H-Bombmxpwr/FPV_Drone/README.md

# FPV Drone Project - ECE 445

This repository contains the design and implementation files for the FPV (First-Person View) Drone project developed by Hunter, Eli, and Griffin for the ECE 445 final project at the University of Illinois in the Spring of 2024.

## Project Overview

The FPV Drone project aims to create a robust and user-friendly drone capable of transmitting real-time video to the user, providing an immersive flying experience. This project was proposed by John M. Hart from the center of Autonomy at the University of Illinois. This repository includes everything that was used in one way or another to make this project. 

## Directories

- Code
   - Low level arduino and c code for flashing the microcontrollers 
- crazyflie_control
   - Software to control the Crazyflie Drone
   - Firmware to flash the Crazyflie Done
   - Extensive debugging tools for setup
- Documents
   - Power Points
   - Design Documents
   - PCB schematics and gerbers
   - Images
   - Personal notes
   - Needed Documentation

## Getting Started
If you are looking to control the drone with your computer you will need:
- Crazyflie 2.0 Drone
- Crazyradio or Crazyflie PA
- Gaming Controller Controller

Then follow the list of steps in [install.md](install.md). 

## The Project

It can be found at this [link](https://courses.engr.illinois.edu/ece445/projects.asp) under "Spring 2024". We were team 64. To save time some material is also linked below:

- [Design Document](Documents/documentation/Design_Document_ECE_445.pdf)
- [Video](https://youtu.be/XnW3fZcY0gs)
- [Final Paper](Documents/documentation/ECE_445_Final_Paper_ECE445.pdf)

## Acknowledgments

- Jon Hart
- Dennis McCann
- Tianxiang Zheng
- Bitlooney

Project Link: [https://github.com/H-Bombmxpwr/FPV_Drone](https://github.com/H-Bombmxpwr/FPV_Drone)
