H-Bombmxpwr/FPV_Drone/Documents/images/ece445blockdiagram.pptx

On Drone System

Camera

Wifi Connection

CrazyFlie Drone

Accelerometer

Barometer

Battery

ESP32 MCU

Sensor Data Overlay

Array Programmer

Wifi Chip

3.3V

3V

CVBS

On Headset System

ESP32 MCU

Wifi Chip

MiniHDMI Conversion

Power Subsystem

Voltage Regulators

3.7V

Battery

MiniHDMI

Headset

IF LED Array

3.3V

Power Subsystem

Voltage Regulators

3.7V
