H-Bombmxpwr/FPV_Drone/Documents/images/64_drone.png

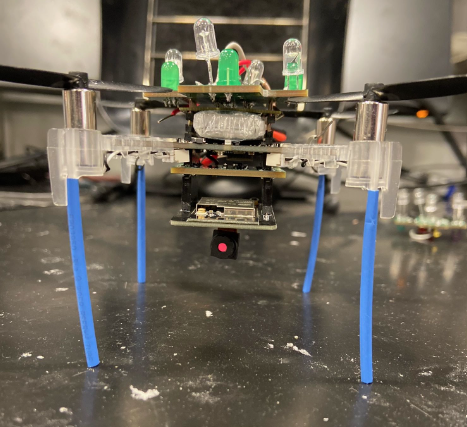
Documents/images/64_drone.png
