H-Bombmxpwr/FPV_Drone/Documents/images/64_headset_board.png

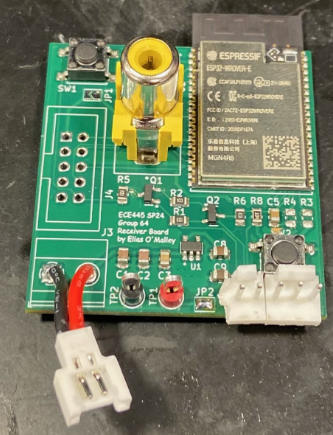
Documents/images/64_headset_board.png
