H-Bombmxpwr/FPV_Drone/Documents/images/av.png

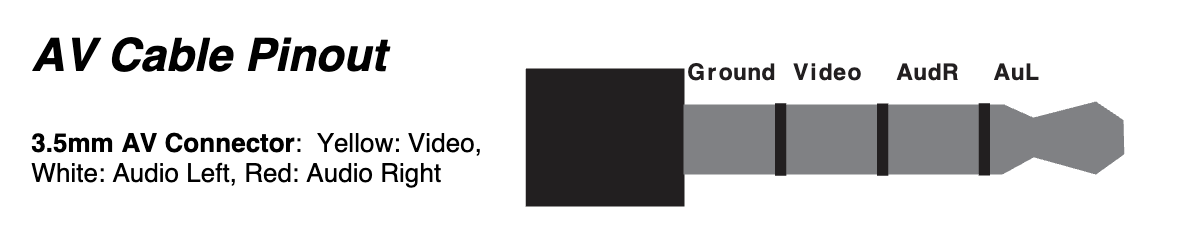
Documents/images/av.png
