H-Bombmxpwr/FPV_Drone/Documents/images/Final Block Diagram.png

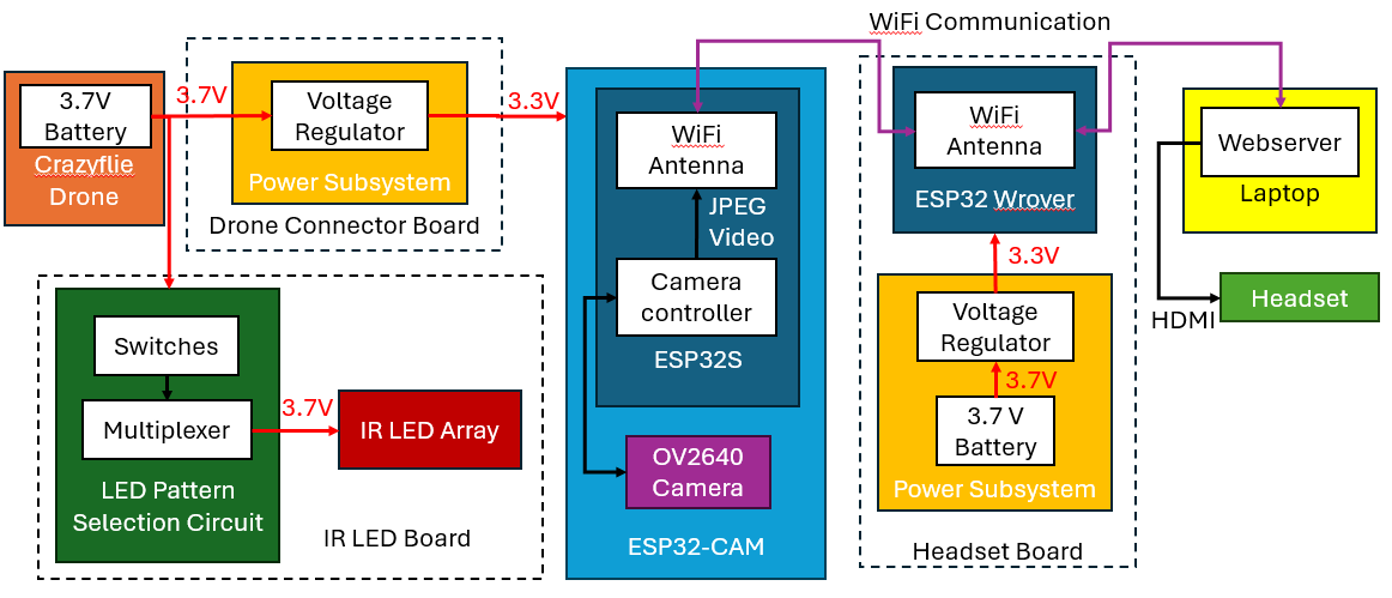
Documents/images/Final Block Diagram.png
