H-Bombmxpwr/FPV_Drone/Documents/images/LEDconfig.png

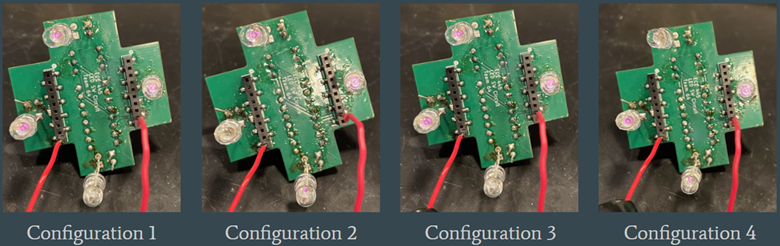
Documents/images/LEDconfig.png
