H-Bombmxpwr/FPV_Drone/Documents/images/locker.png

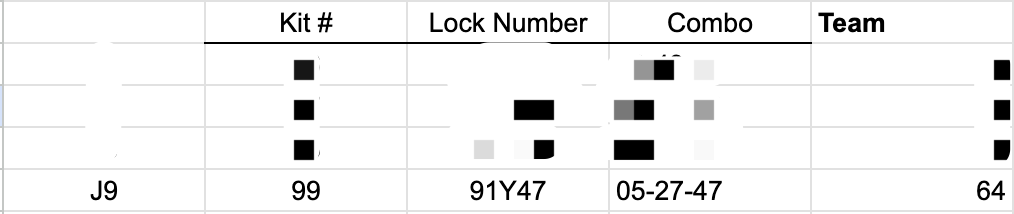
Documents/images/locker.png
