H-Bombmxpwr/FPV_Drone/Documents/kicad/adapter_board/adapter_board/visuals/adapter_board_bottom.png

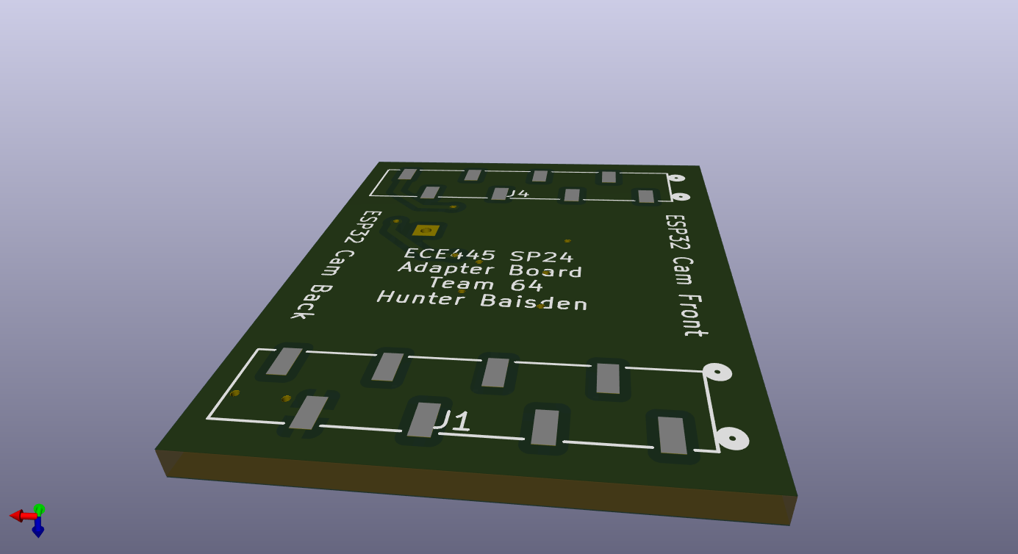
Documents/kicad/adapter_board/adapter_board/visuals/adapter_board_bottom.png
