H-Bombmxpwr/FPV_Drone/Documents/kicad/adapter_board/adapter_board/visuals/adapter_board_pcb.png

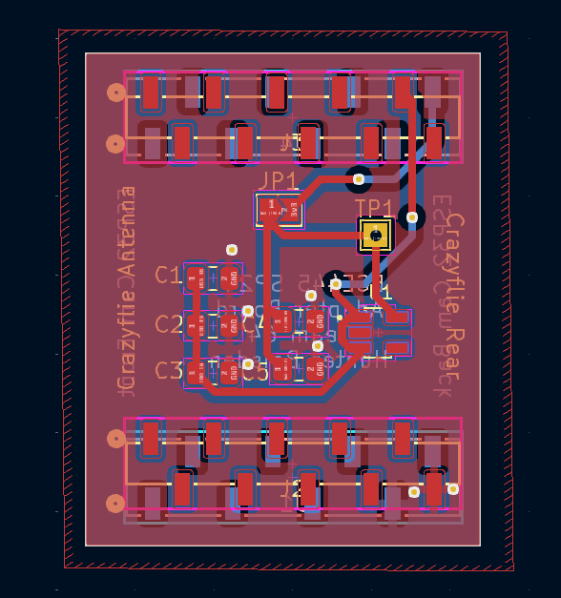
Documents/kicad/adapter_board/adapter_board/visuals/adapter_board_pcb.png
