H-Bombmxpwr/FPV_Drone/Documents/kicad/adapter_board/adapter_board/AP2112K_3_3TRG1/AP2112K-3.3TRG1.step

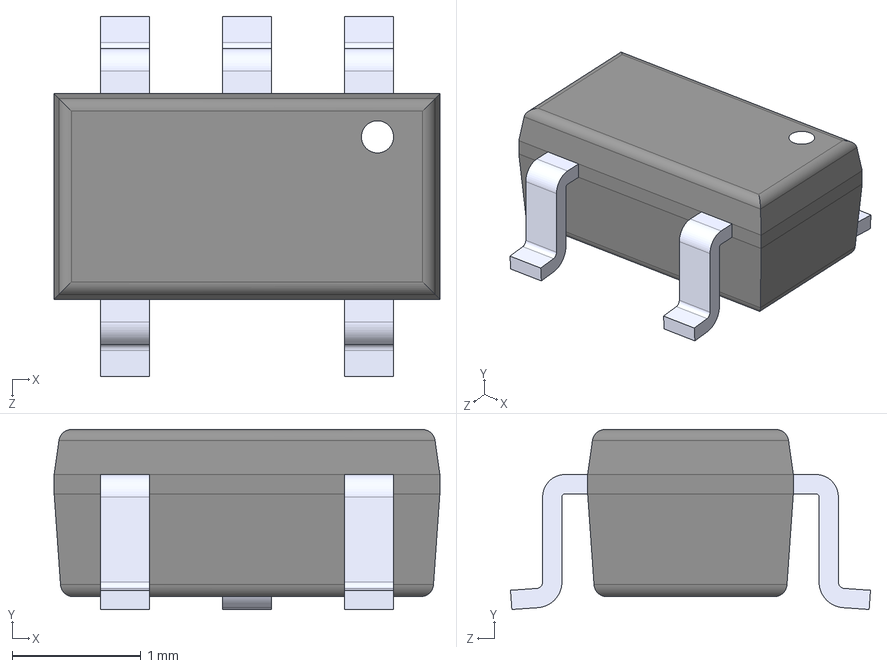
[picture p19: CAD file, 2024-03-31]
Documents/kicad/adapter_board/adapter_board/AP2112K_3_3TRG1/AP2112K-3.3TRG1.step
3.00 x 1.40 x 2.80 mm
