H-Bombmxpwr/FPV_Drone/Documents/kicad/LED_BOARD/L08R5000Q1/L08R5000Q1.step

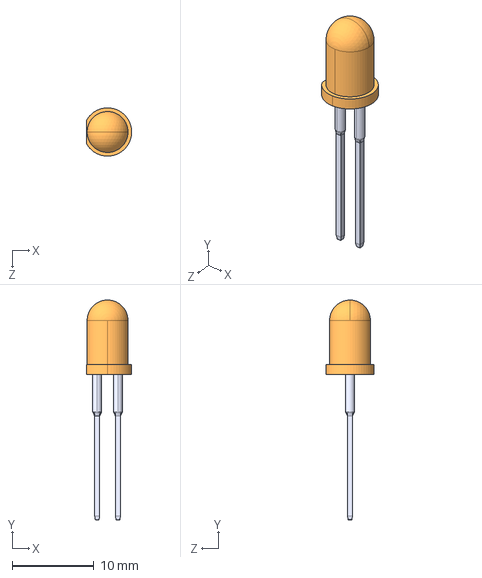
[picture p20: CAD file, 2024-03-31]
Documents/kicad/LED_BOARD/L08R5000Q1/L08R5000Q1.step
5.55 x 26.9 x 5.90 mm
