H-Bombmxpwr/FPV_Drone/Documents/kicad/adapter_board/adapter_board/visuals/adapter_board-B_Silkscreen.pdf

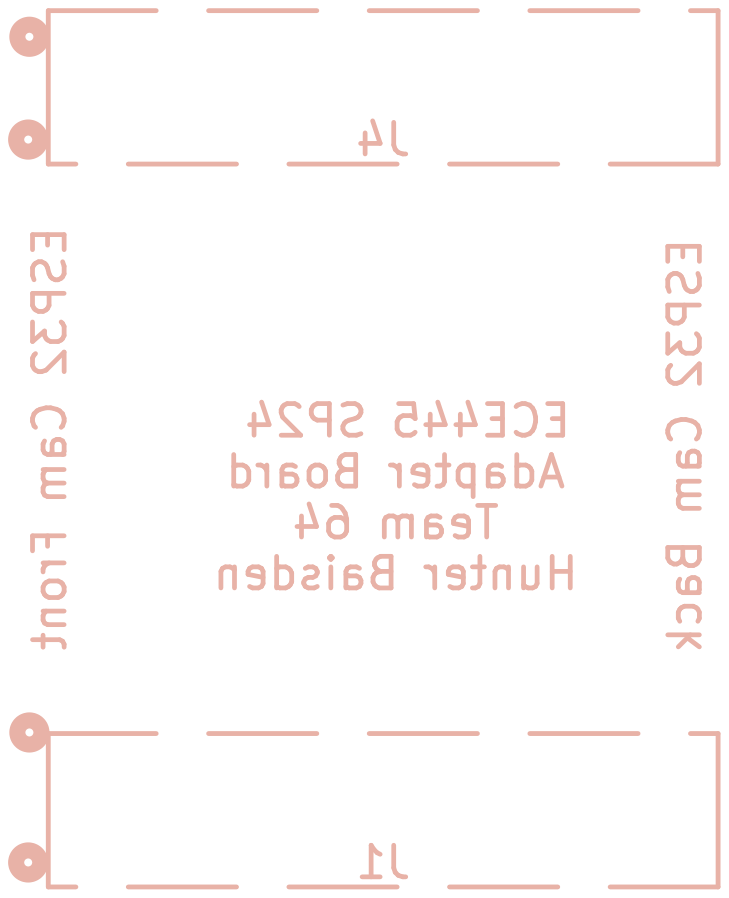
[picture p28: page 1]

Baisden Hunter ESP32 Cam Front ESP32 Cam Back
