H-Bombmxpwr/FPV_Drone/Documents/kicad/adapter_board/adapter_board/visuals/adapter_board-F_Silkscreen.pdf

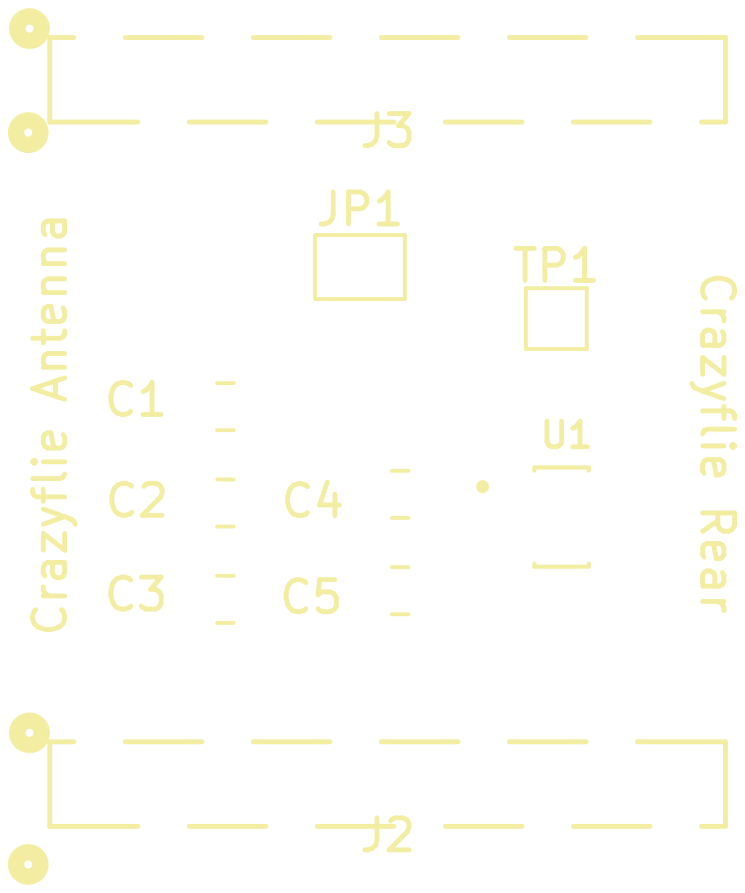
[picture p29: page 1]

Crazyflie Rear Crazyflie Antenna
