H-Bombmxpwr/FPV_Drone/Documents/kicad/adapter_board/adapter_board/visuals/adapter_board.pdf

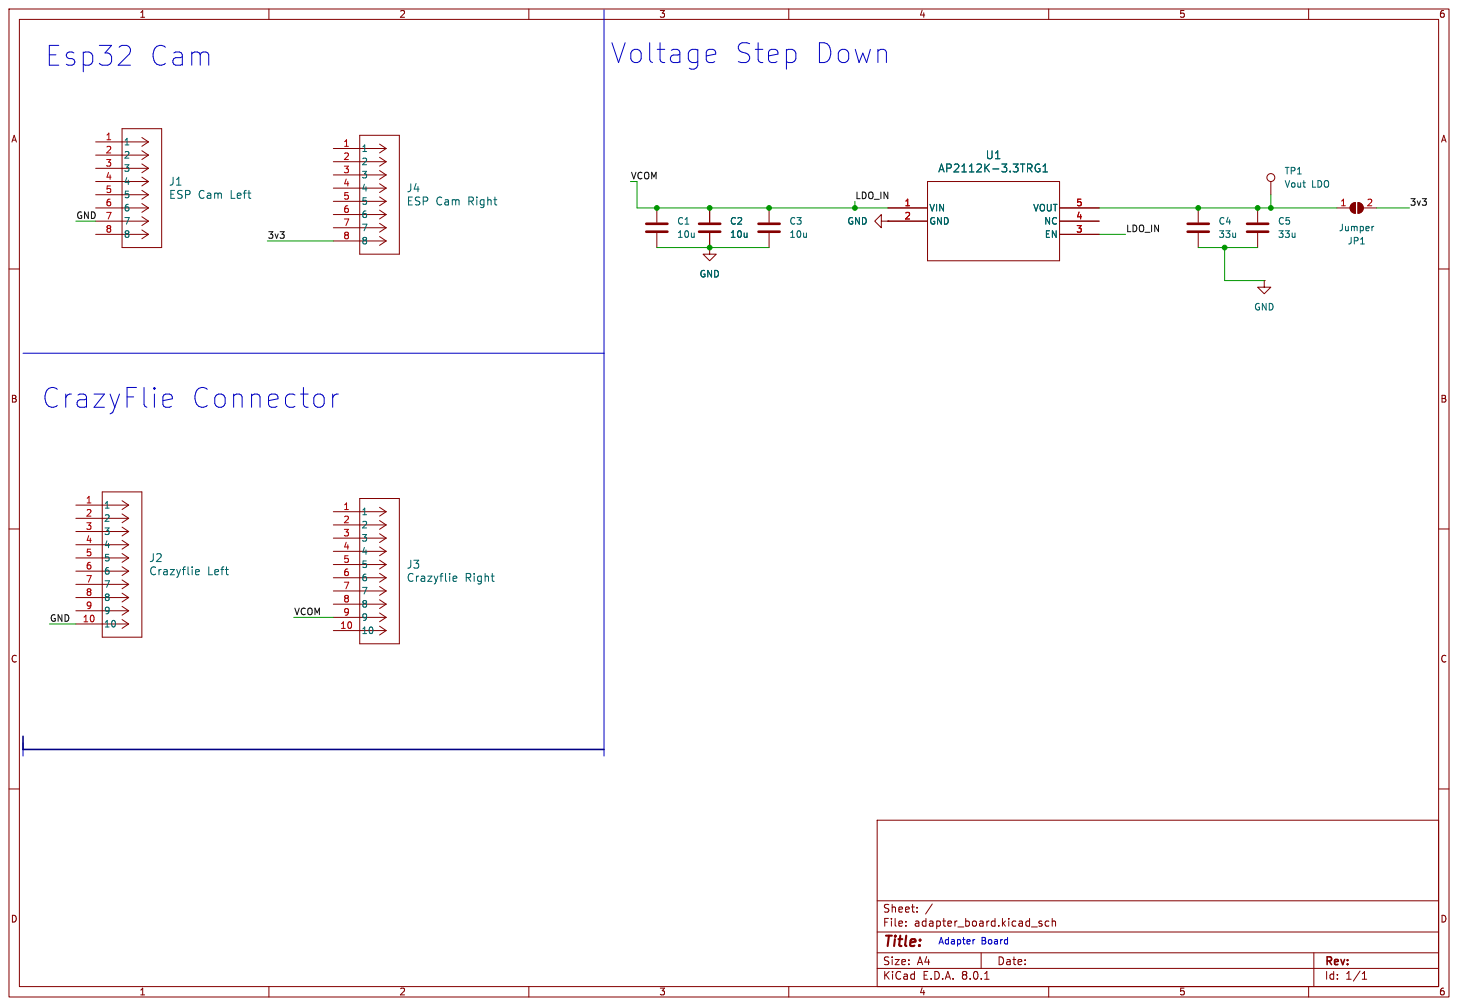
[picture p30: page 1]

Id: 1/1 Title: File: adapter_board.kicad_sch Sheet: /
