H-Bombmxpwr/FPV_Drone/Documents/kicad/adapter_board/adapter_board/visuals/adapter_board-B_Cu.pdf

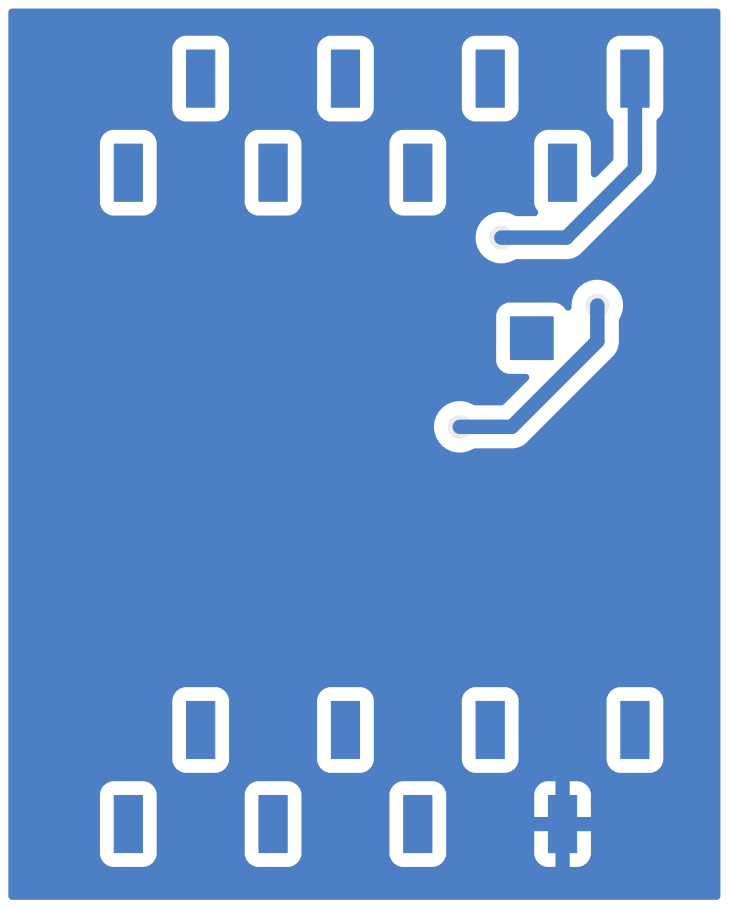
[picture p31: page 1]
