H-Bombmxpwr/FPV_Drone/Documents/kicad/adapter_board/adapter_board/visuals/adapter_board-B_Mask.pdf

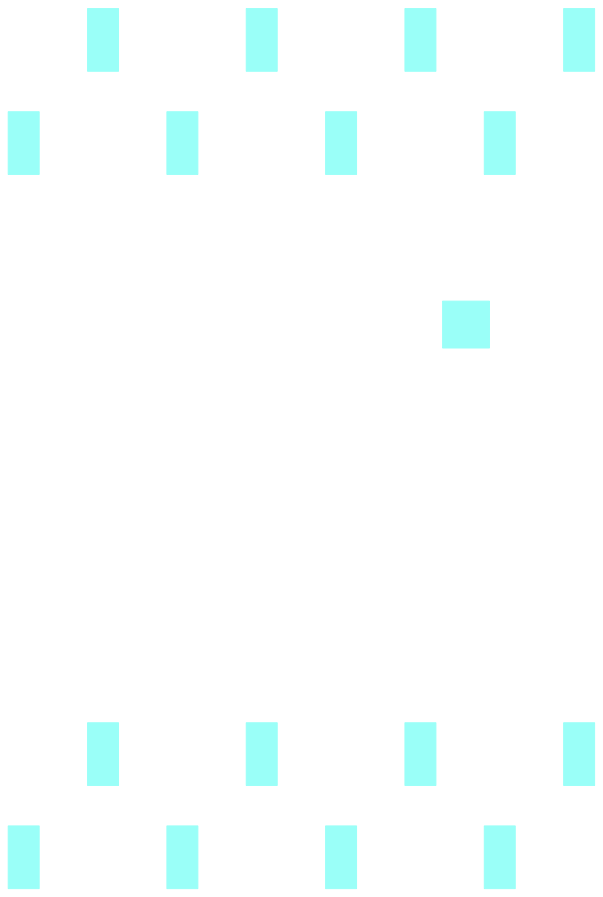
[picture p32: page 1]
