H-Bombmxpwr/FPV_Drone/Documents/kicad/adapter_board/adapter_board/visuals/adapter_board-B_Paste.pdf

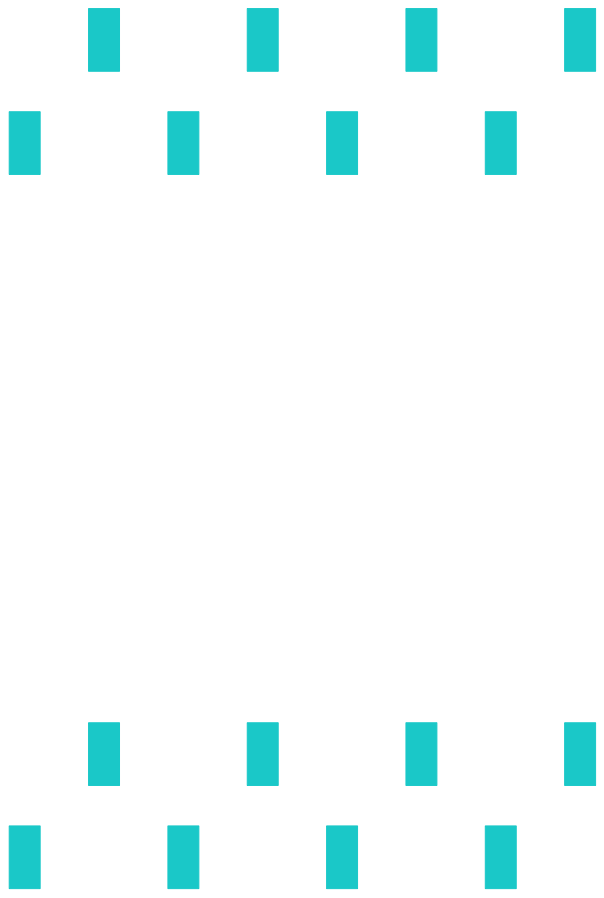
[picture p33: page 1]
