H-Bombmxpwr/FPV_Drone/Documents/kicad/adapter_board/adapter_board/visuals/adapter_board-F_Cu.pdf

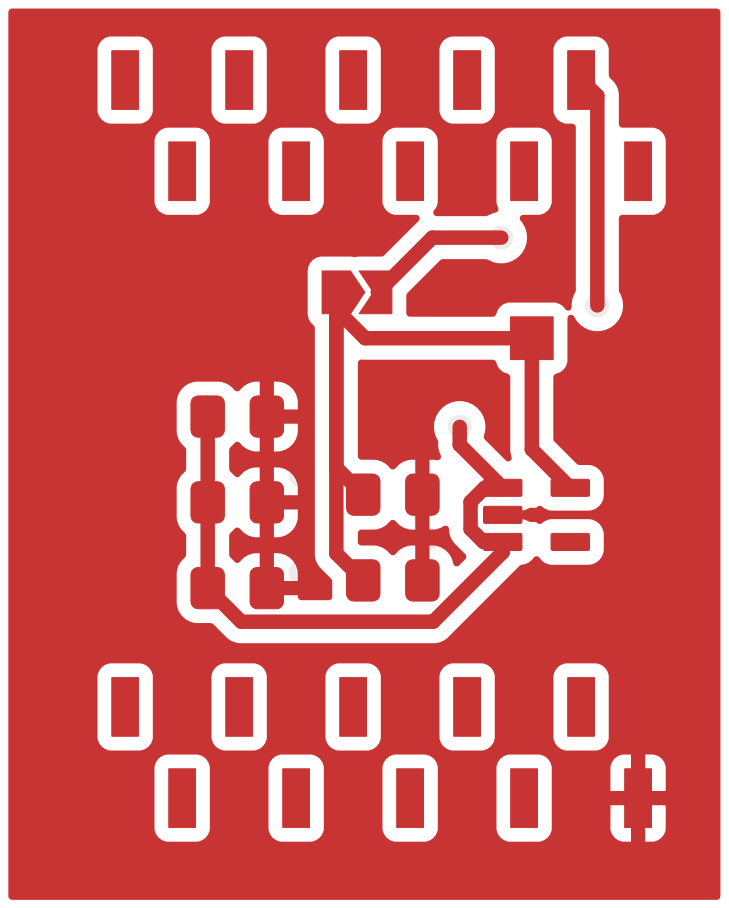
[picture p34: page 1]
