H-Bombmxpwr/FPV_Drone/Documents/kicad/adapter_board/adapter_board/visuals/adapter_board-F_Mask.pdf

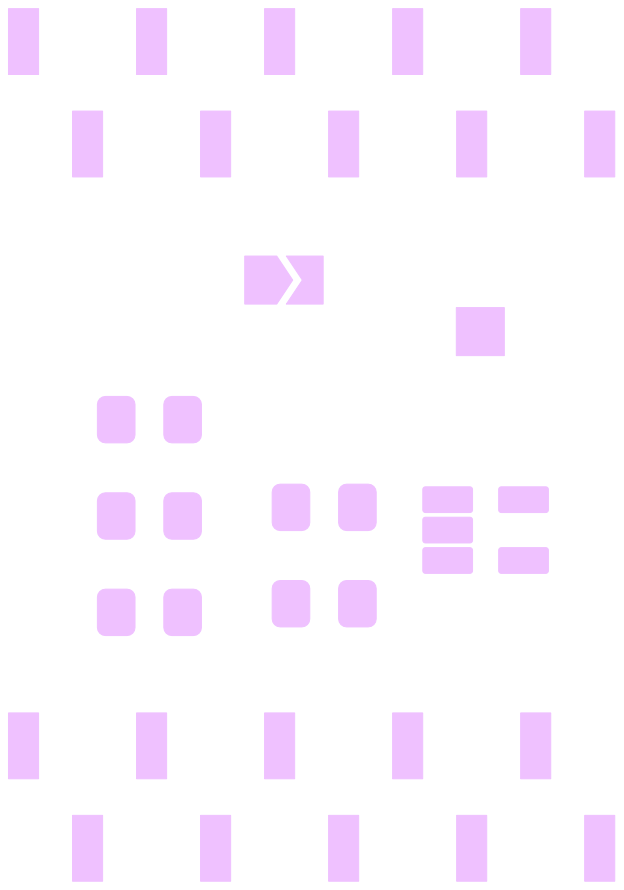
[picture p35: page 1]
