H-Bombmxpwr/FPV_Drone/Documents/kicad/adapter_board/adapter_board/visuals/adapter_board-F_Paste.pdf

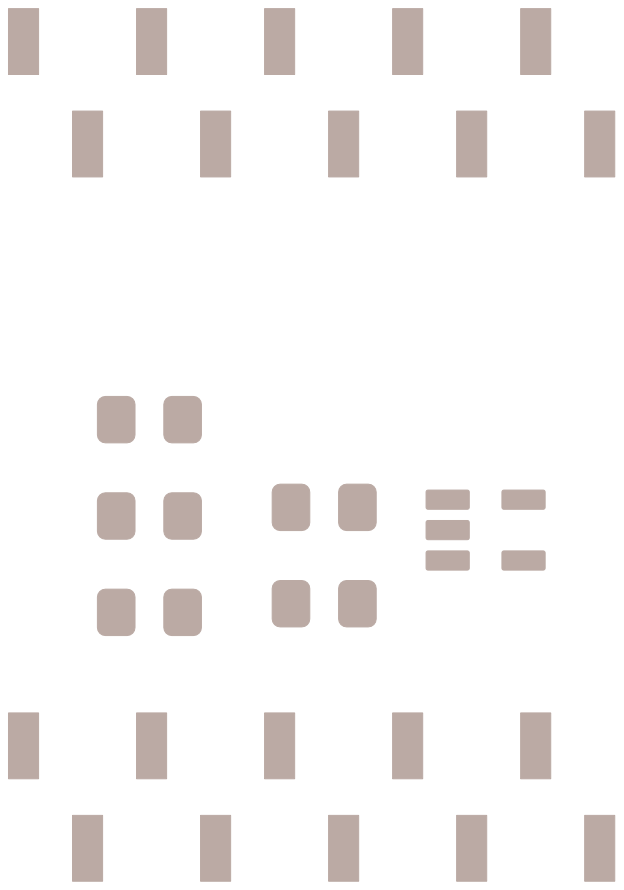
[picture p36: page 1]
