H-Bombmxpwr/FPV_Drone/Documents/kicad/LED_BOARD/Led circuit.kicad_pcb

## KiCad design Documents/kicad/LED_BOARD/Led circuit.kicad_pcb (2024-05-03)

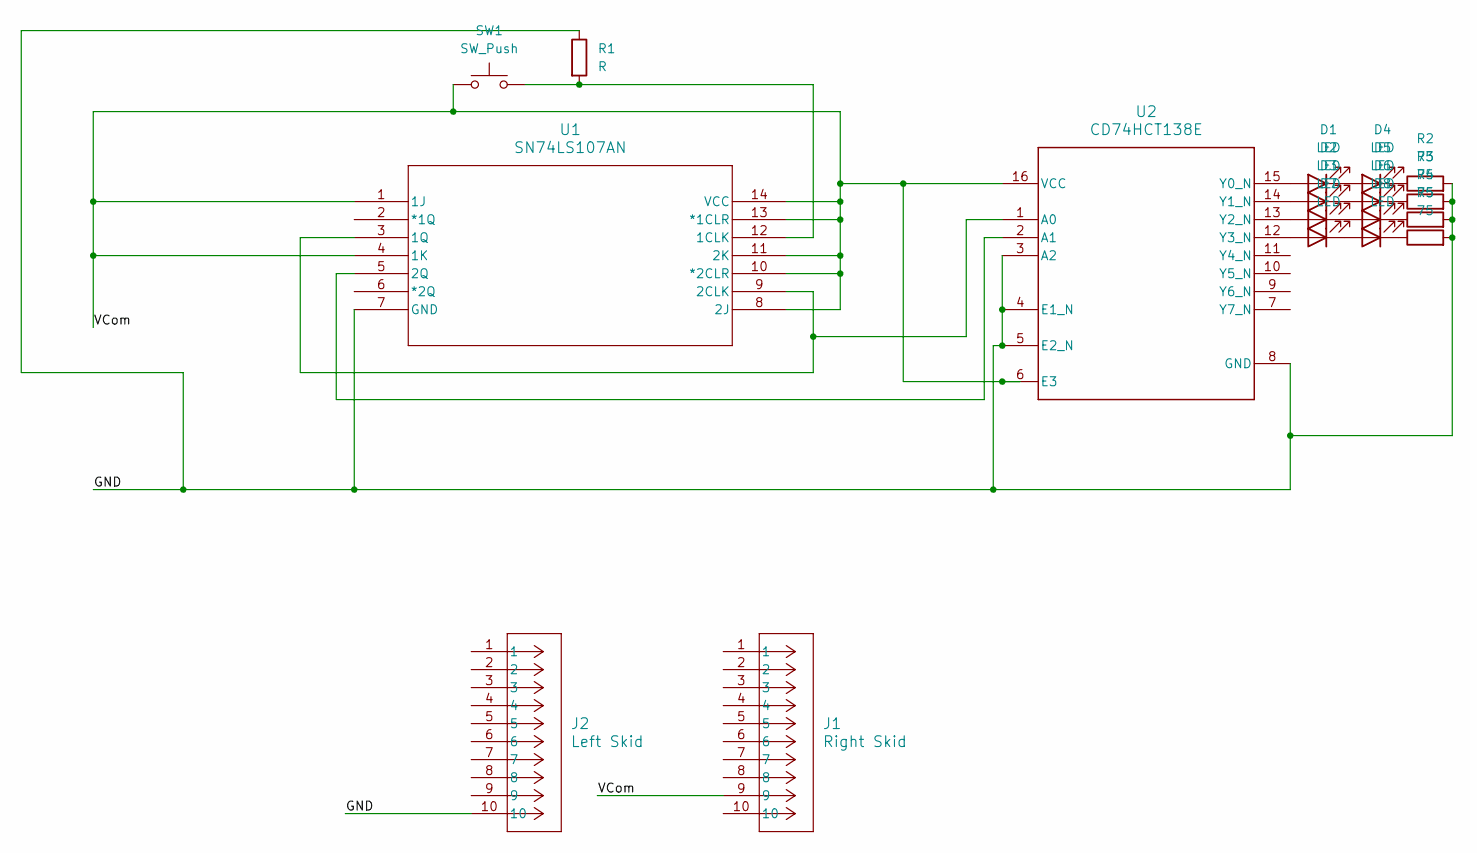
[picture p37: schematic Led circuit.kicad_sch]

Parts:
D1, D2, D3, D4, D5, D6, D7, D8: LED; LED_D2.0mm_W4.8mm_H2.5mm_FlatTop
J1: Right Skid; Connector
J2: Left Skid; Connector
R1: R
R2, R3, R4, R5: 75; R_0805_2012Metric_Pad1.20x1.40mm_HandSolder
SW1: SW_Push
U1: SN74LS107AN
U2: CD74HCT138E

Connections:
/GND: J2.10, R1.1, R2.2, R3.2, R4.2, R5.2, U1.7 (GND), U2.3 (A2), U2.4 (E1_N), U2.5 (E2_N), U2.8 (GND); also elsewhere on the board
/VCom: J1.9, SW1.1, U1.1 (1J), U1.4 (1K), U1.8 (2J), U1.10 (*2CLR), U1.11 (2K), U1.13 (*1CLR), U1.14 (VCC), U2.6 (E3), U2.16 (VCC)
unnamed: D1.2 (A), U2.15 (Y0_N)
unnamed: D1.1 (K), D4.2 (A)
unnamed: D2.2 (A), U2.14 (Y1_N)
unnamed: D2.1 (K), D5.2 (A)
unnamed: D3.2 (A), U2.13 (Y2_N)
unnamed: D3.1 (K), D6.2 (A)
unnamed: D4.1 (K), R2.1
unnamed: D5.1 (K), R3.1
unnamed: D6.1 (K), R4.1
unnamed: D7.2 (A), U2.12 (Y3_N)
unnamed: D7.1 (K), D8.2 (A)
unnamed: D8.1 (K), R5.1
unnamed 14: R1.2, SW1.2, U1.12 (1CLK); also elsewhere on the board
unnamed: U1.3 (1Q), U1.9 (2CLK), U2.1 (A0)
unnamed: U1.5 (2Q), U2.2 (A1)

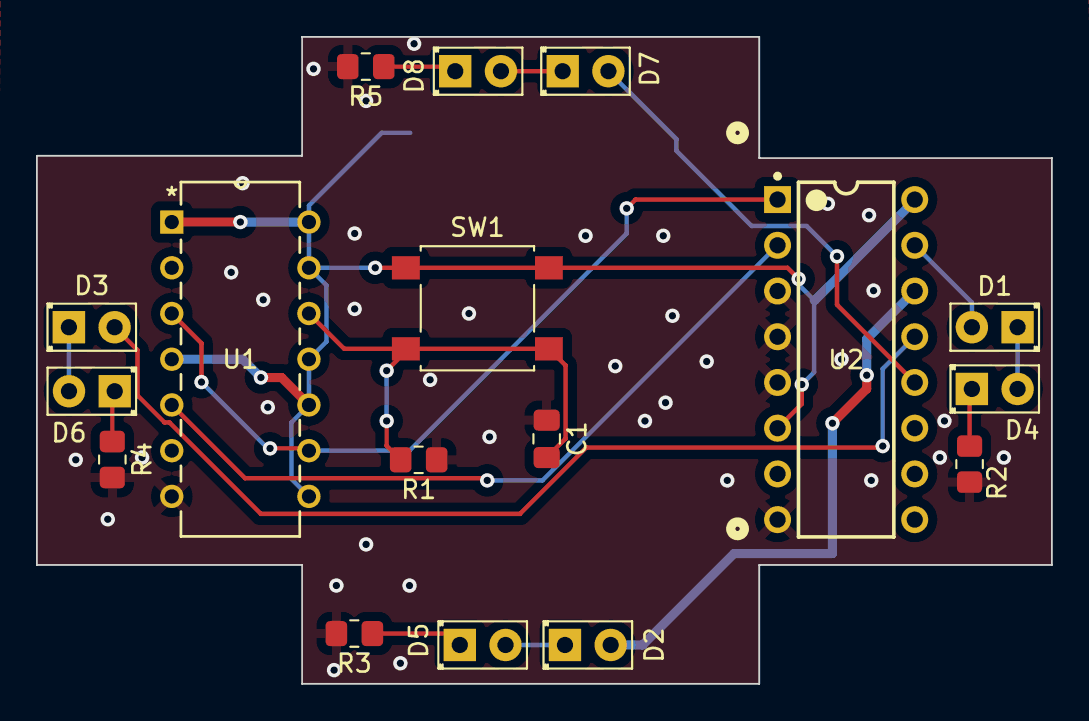
[picture p38: board Led circuit.kicad_pcb from above]

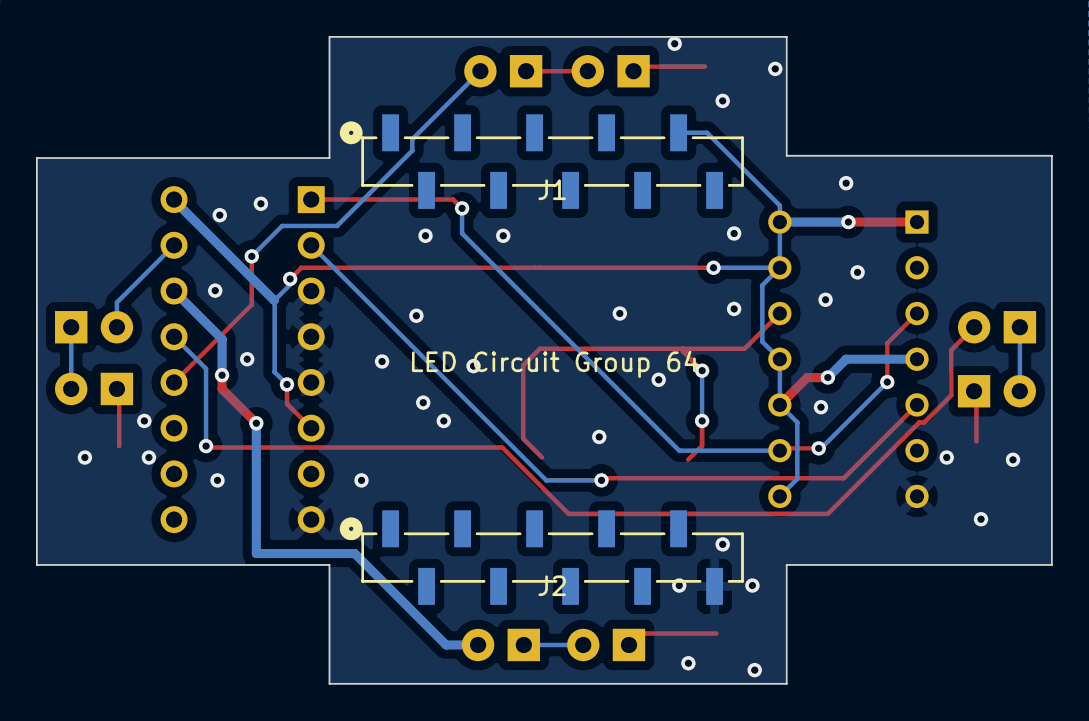
[picture p39: board Led circuit.kicad_pcb from below]

Board: 2 copper layers, 56.4 x 35.9 mm, 19 parts (2 on the bottom side), 17 nets.

Other parts of the board:
C1: C; C_0805_2012Metric_Pad1.18x1.45mm_HandSolder

Their connections:
/GND: C1.1; also elsewhere on the board
unnamed 14: C1.2; also elsewhere on the board
