H-Bombmxpwr/FPV_Drone/Documents/kicad/ece445_headset/ece445_headset.kicad_pcb

## KiCad design Documents/kicad/ece445_headset/ece445_headset.kicad_pcb (2024-04-08)

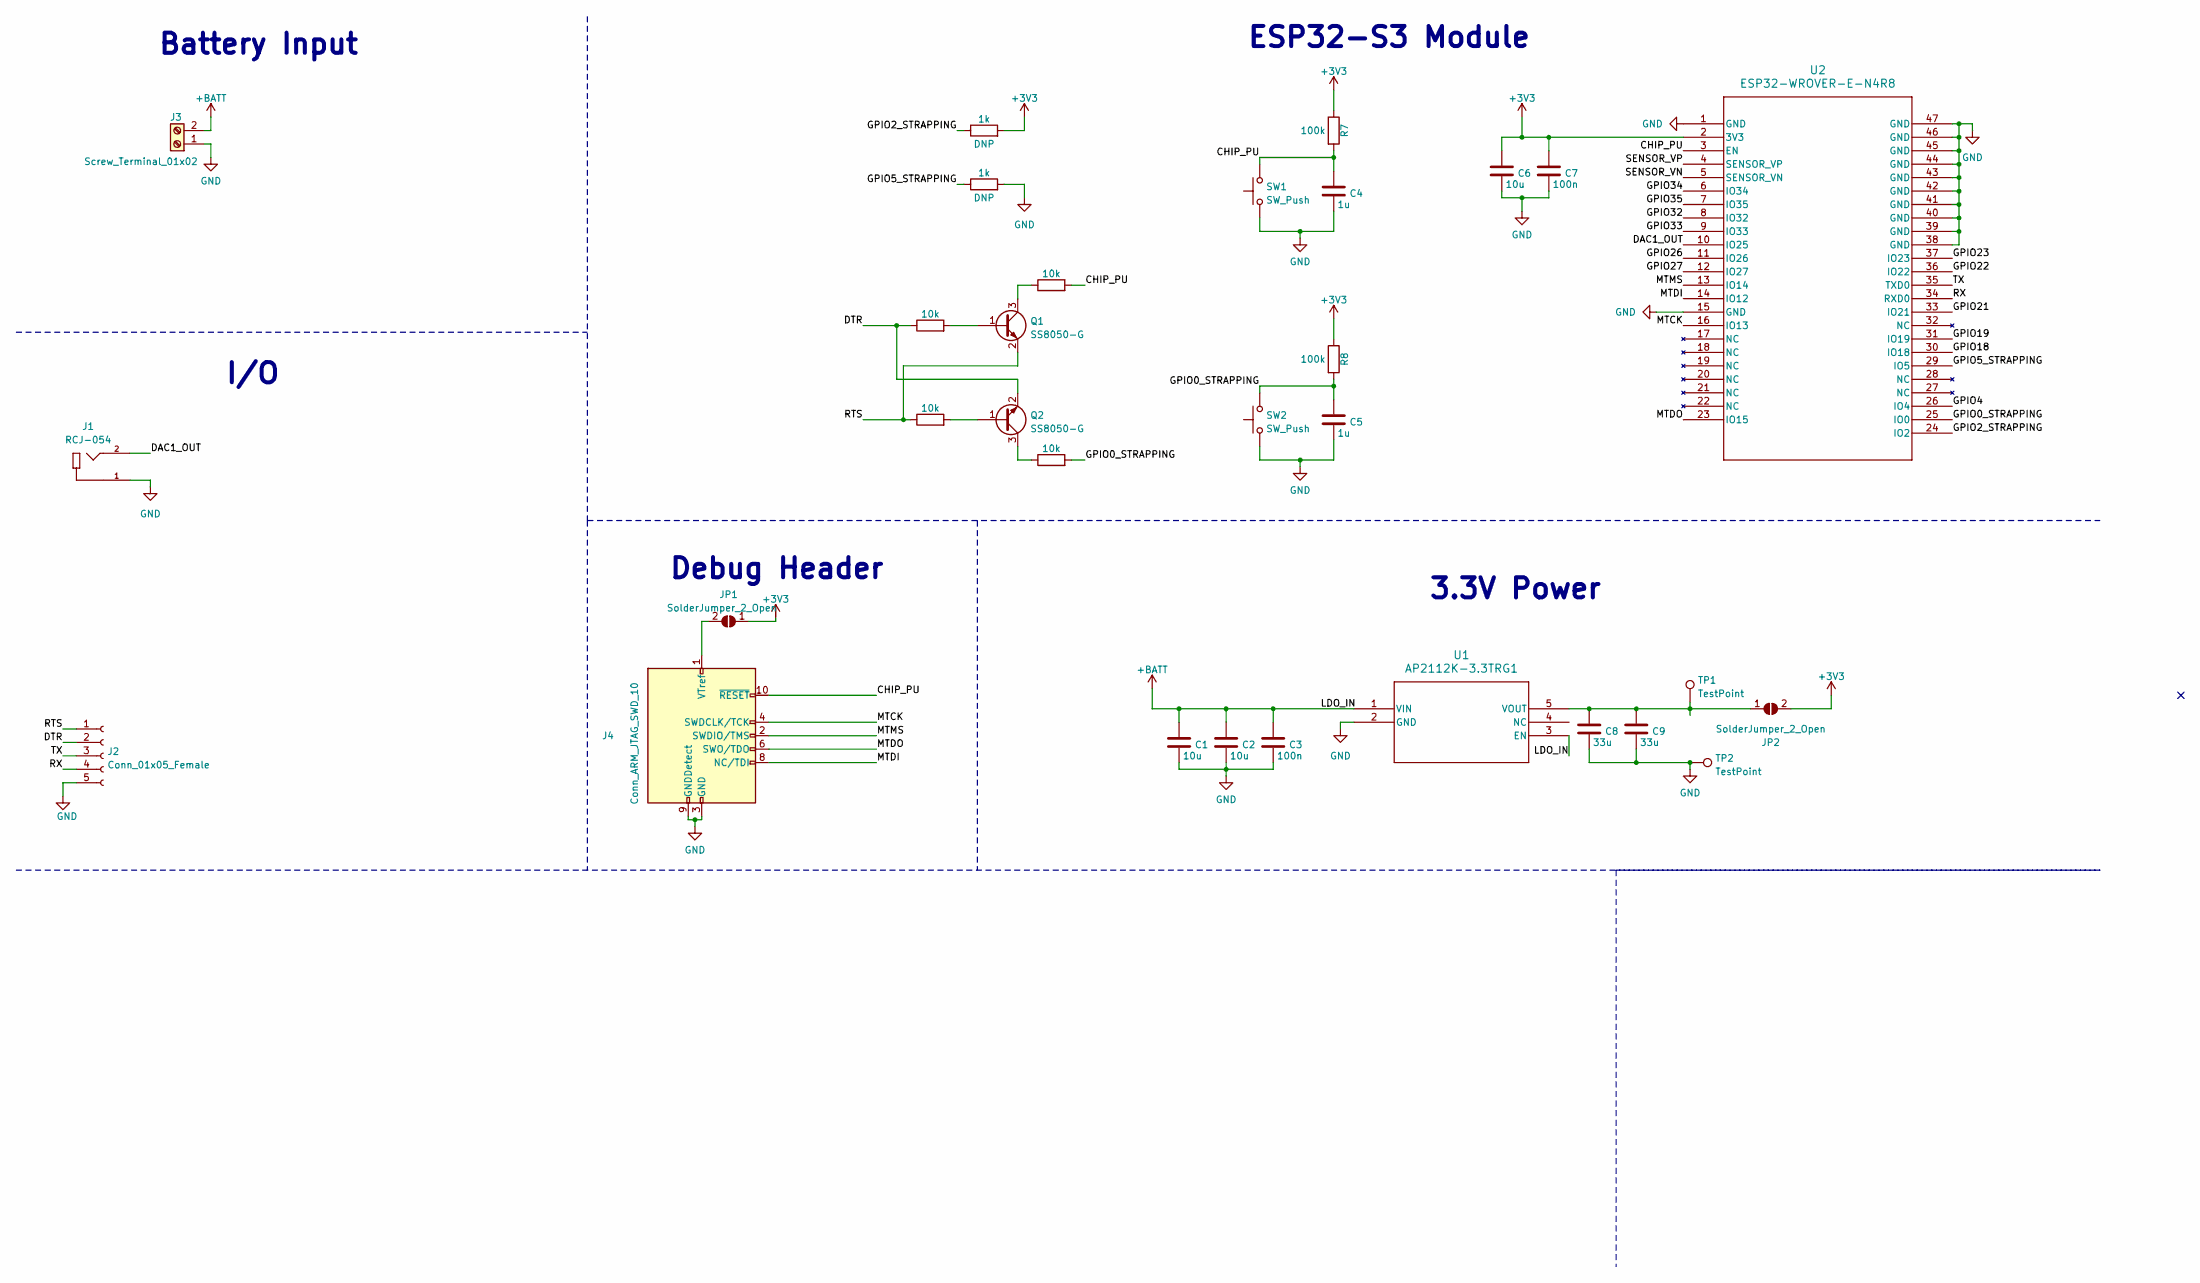
[picture p40: schematic ece445_headset.kicad_sch, ESP32 Example: Motor Controller]

Parts:
C1, C2, C6: 10u; C_0805_2012Metric
C3, C7: 100n; C_0805_2012Metric
C4, C5: 1u; C_0805_2012Metric
C8, C9: 33u; C_0805_2012Metric
J1: RCJ-054; CUI_RCJ-054
J2: Conn_01x05_Female; PinHeader_1x05_P2.54mm_Vertical
J3: Screw_Terminal_01x02; TerminalBlock_Phoenix_MKDS-1,5-2-5.08_1x02_P5.08mm_Horizont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
J4: Conn_ARM_JTAG_SWD_10; IDC-Header_2x05_P2.54mm_Vertical
JP1, JP2: SolderJumper_2_Open; SolderJumper-2_P1.3mm_Open_TrianglePad1.0x1.5mm
Q1, Q2: SS8050-G; SOT-23
R1, R2, R5, R6: 10k; R_0805_2012Metric
R3, R4: 1k; R_0805_2012Metric
R7, R8: 100k; R_0805_2012Metric
SW1, SW2: SW_Push; SW_SPST_B3S-1000
TP1, TP2: TestPoint; TestPoint_Keystone_5010-5014_Multipurpose
U1: AP2112K-3.3TRG1; SOT95P285X140-5N
U2: ESP32-WROVER-E-N4R8; ESP32­WROVER­E&slash_ESP32­WROVER­IE_EXP

Connections:
+3V3: C6.1, C7.1, JP1.1 (A), JP2.2 (B), R3.2, R7.1, R8.1, U2.2 (3V3)
+BATT: C1.1, C2.1, C3.1, J3.2, U1.1 (VIN), U1.3 (EN)
/CHIP_PU: C4.1, J4.10 (~RESET), R5.2, R7.2, SW1.2, U2.3 (EN)
/DAC1_OUT: J1.2, U2.10 (IO25)
/DTR: J2.2, Q2.2 (E), R1.1
/GPIO0_STRAPPING: C5.1, R6.2, R8.2, SW2.2, U2.25 (IO0)
/GPIO2_STRAPPING: R3.1, U2.24 (IO2)
/GPIO4: U2.26 (IO4)
/GPIO5_STRAPPING: R4.1, U2.29 (IO5)
/GPIO18: U2.30 (IO18)
/GPIO19: U2.31 (IO19)
/GPIO21: U2.33 (IO21)
/GPIO22: U2.36 (IO22)
/GPIO23: U2.37 (IO23)
/GPIO26: U2.11 (IO26)
/GPIO27: U2.12 (IO27)
/GPIO32: U2.8 (IO32)
/GPIO33: U2.9 (IO33)
/GPIO34: U2.6 (IO34)
/GPIO35: U2.7 (IO35)
/MTCK: J4.4 (SWDCLK/TCK), U2.16 (IO13)
/MTDI: J4.8 (NC/TDI), U2.14 (IO12)
/MTDO: J4.6 (SWO/TDO), U2.23 (IO15)
/MTMS: J4.2 (SWDIO/TMS), U2.13 (IO14)
/RTS: J2.1, Q1.2 (E), R2.1
/RX: J2.4, U2.34 (RXD0)
/SENSOR_VN: U2.5 (SENSOR_VN)
/SENSOR_VP: U2.4 (SENSOR_VP)
/TX: J2.3, U2.35 (TXD0)
GND: C1.2, C2.2, C3.2, C4.2, C5.2, C6.2, C7.2, C8.2, C9.2, J1.1, J2.5, J3.1, J4.3 (GND), J4.5 (GND), J4.9 (GNDDetect), R4.2, SW1.1, SW2.1, TP2.1, U1.2 (GND), U2.1 (GND), U2.15 (GND), U2.38 (GND), U2.39 (GND), U2.40 (GND), U2.41 (GND), U2.42 (GND), U2.43 (GND), U2.44 (GND), U2.45 (GND), U2.46 (GND), U2.47 (GND)
unnamed: J4.1 (VTref), JP1.2 (B)
unnamed: C8.1, C9.1, JP2.1 (A), TP1.1, U1.5 (VOUT)
unnamed: Q1.1 (B), R1.2
unnamed: Q1.3 (C), R5.1
unnamed: Q2.1 (B), R2.2
unnamed: Q2.3 (C), R6.1

Notes on the sheet:
ESP32-S3 Module
Debug Header
3.3V Power
Battery Input
I/O

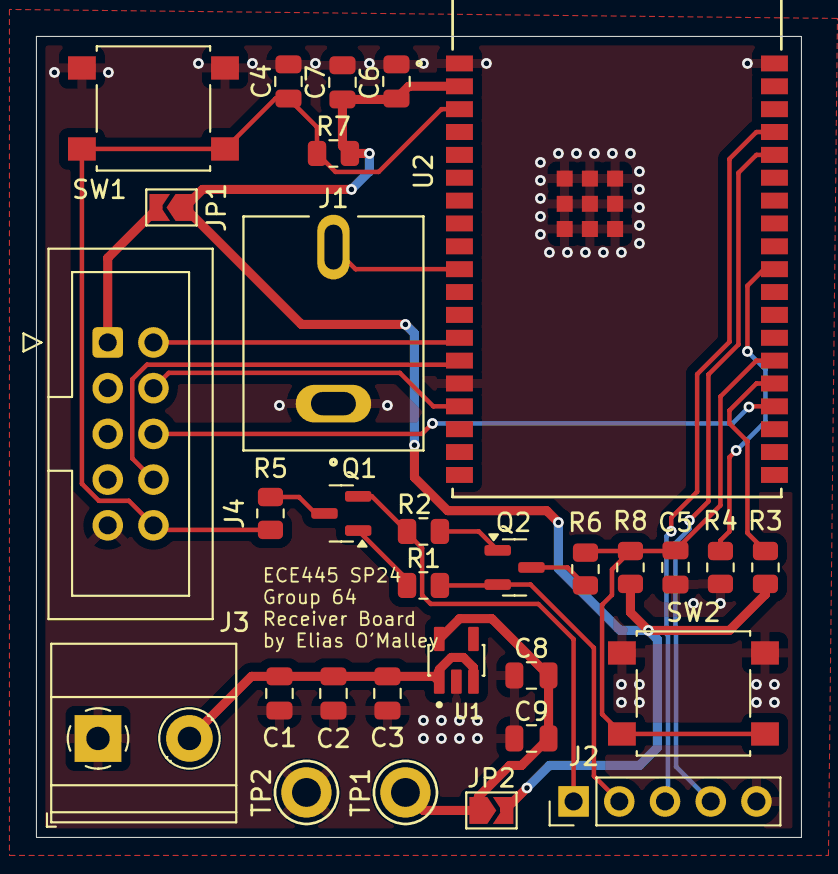
[picture p41: board ece445_headset.kicad_pcb from above]

Board: 2 copper layers, 42.5 x 44.5 mm, 31 parts (0 on the bottom side), 22 nets.
