H-Bombmxpwr/FPV_Drone/Documents/kicad/adapter_board/adapter_board/adapter_board.kicad_pcb

## KiCad design Documents/kicad/adapter_board/adapter_board/adapter_board.kicad_pcb (2024-04-01)

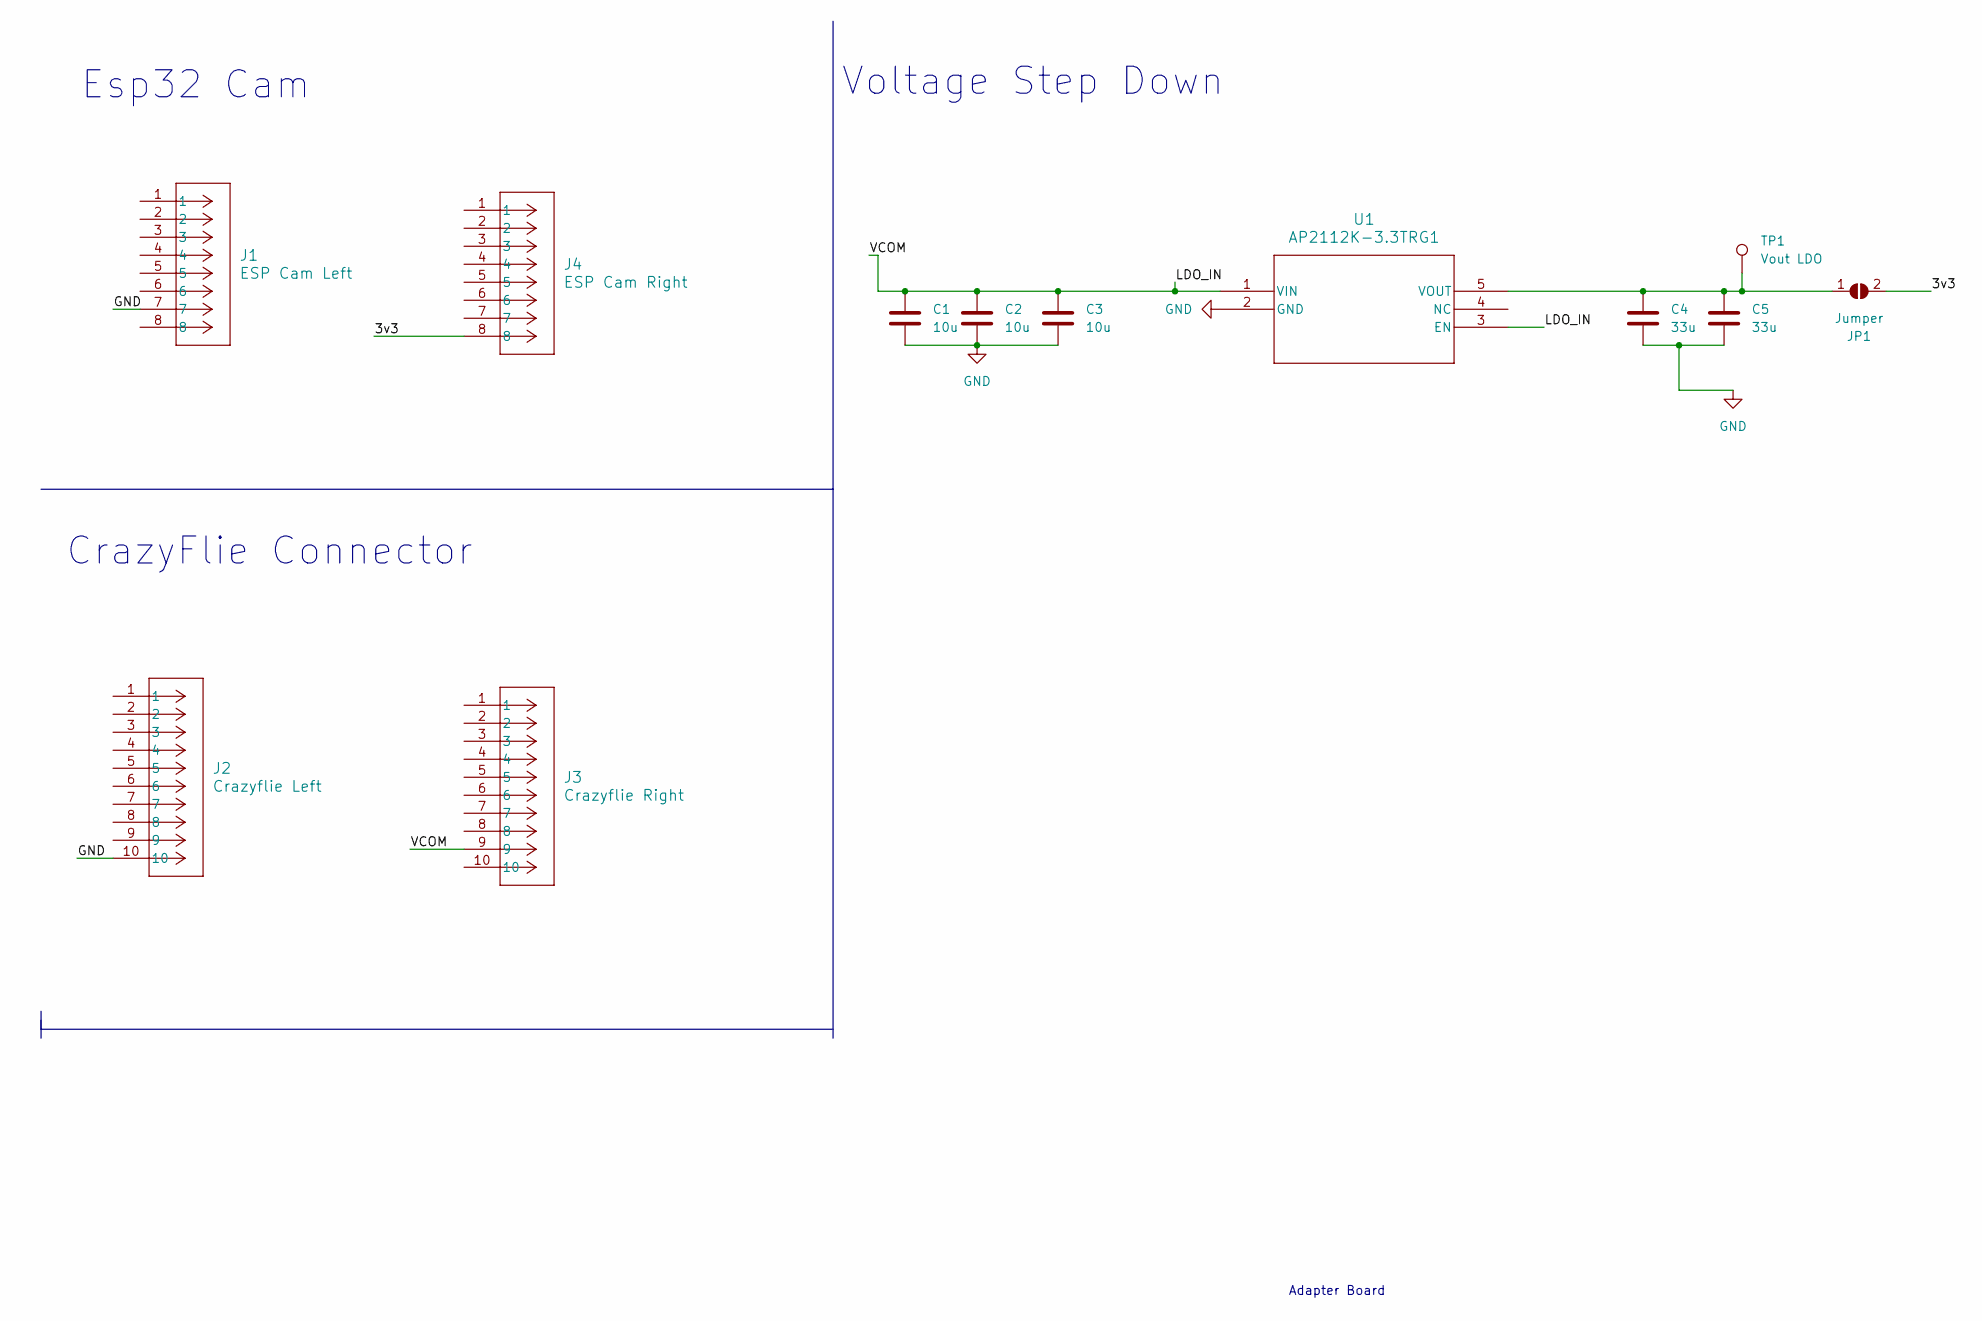
[picture p42: schematic adapter_board.kicad_sch]

Parts:
C1, C2, C3: 10u; C_0805_2012Metric_Pad1.18x1.45mm_HandSolder
C4, C5: 33u; C_0805_2012Metric_Pad1.18x1.45mm_HandSolder
J1: ESP Cam Left; CONN_NPTC081KFXC-RC_SUL
J2: Crazyflie Left; CONN10X1_NPPN101BFLC-RC_SUL
J3: Crazyflie Right; CONN10X1_NPPN101BFLC-RC_SUL
J4: ESP Cam Right; CONN_NPTC081KFXC-RC_SUL
JP1: Jumper; SolderJumper-2_P1.3mm_Open_TrianglePad1.0x1.5mm
TP1: Vout LDO; TestPoint_THTPad_1.5x1.5mm_Drill0.7mm
U1: AP2112K-3.3TRG1; SOT95P285X140-5N

Connections:
/3v3: J4.8, JP1.2 (B)
/LDO_IN: C1.1, C2.1, C3.1, J3.9, U1.1 (VIN), U1.3 (EN)
GND: C1.2, C2.2, C3.2, C4.2, C5.2, J1.7, J2.10, U1.2 (GND)
unnamed: C4.1, C5.1, JP1.1 (A), TP1.1, U1.5 (VOUT)

Notes on the sheet:
Adapter Board
Voltage Step Down
Esp32 Cam
CrazyFlie Connector

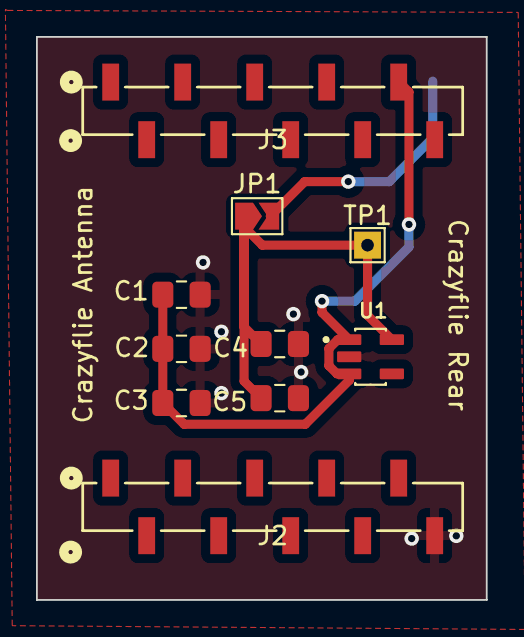
[picture p43: board adapter_board.kicad_pcb from above]

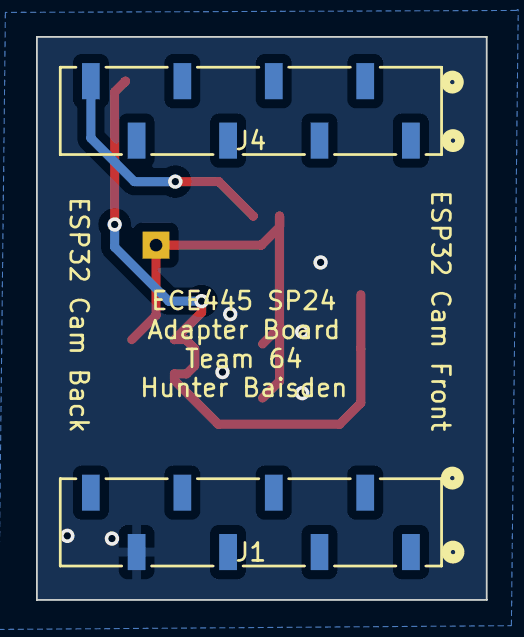
[picture p44: board adapter_board.kicad_pcb from below]

Board: 2 copper layers, 25.0 x 31.3 mm, 12 parts (2 on the bottom side), 4 nets.
