H-Bombmxpwr/FPV_Drone/Code/video_webserver/video_webserver.ino

#include <OV2640.h>
#include <WiFi.h>
#include <WebServer.h>
#include <WiFiClient.h>

OV2640 cam;

WebServer server(80);

const char* ssid = "ESP32 Headset Board";
const char* password = "beepboop";

void handle_jpg_stream(void)
{
    WiFiClient client = server.client();
    Serial.println(client.localIP());
    Serial.println(client.remotePort());
    String response = "HTTP/1.1 200 OK\r\n";
    response += "Content-Type: multipart/x-mixed-replace; boundary=frame\r\n\r\n";
    server.sendContent(response);

    while (1)
    {
        cam.run();
        if (!client.connected())
            break;
        response = "--frame\r\n";
        response += "Content-Type: image/jpeg\r\n\r\n";
        server.sendContent(response);

        client.write((char *)cam.getfb(), cam.getSize());
        server.sendContent("\r\n");
        if (!client.connected())
            break;
    }
}

void handleNotFound()
{
    String message = "Server is running!\n\n";
    message += "URI: ";
    message += server.uri();
    message += "\nMethod: ";
    message += (server.method() == HTTP_GET) ? "GET" : "POST";
    message += "\nArguments: ";
    message += server.args();
    message += "\n";
    server.send(200, "text/plain", message);
}

void setup()
{
  Serial.begin(115200);
  Serial.setDebugOutput(true);
  Serial.println();

  WiFi.softAP(ssid, password);
  Serial.println("IP address: ");
  Serial.println(WiFi.localIP());

  cam.init(esp32cam_aithinker_config);

  server.on("/", HTTP_GET, handle_jpg_stream);
  server.onNotFound(handleNotFound);
  server.begin();
}

void loop()
{
  server.handleClient();
}
