H-Bombmxpwr/FPV_Drone/(commit log)

2024-02-06 adding more files
    [baisden2_miniencabulator.kicad_pcb, baisden2_miniencabulator.kicad_sch]
2024-03-29 Adding Current Draft of LED Circuit Schematic
    [Led circuit.kicad_sch]
2024-03-31 new stuff
    [adapter_board.kicad_pcb, adapter_board.kicad_sch]
2024-03-31 adapter board changes
    [adapter_board.kicad_sch]
2024-03-31 adding LEd footprint
    [L08R5000Q1.step, adapter_board.kicad_sch]
2024-03-31 schematic finished
    [AP2112K-3.3TRG1.step, adapter_board.kicad_pcb, adapter_board.kicad_sch]
2024-03-31 finished board
    [adapter_board.kicad_pcb, adapter_board.kicad_sch]
2024-04-01 adding gerber files
    [adapter_board-B_Cu.gbl, adapter_board-B_Mask.gbs, adapter_board-B_Paste.gbp, adapter_board-B_Silkscreen.gbo, adapter_board-Edge_Cuts.gm1, adapter_board-F_Cu.gtl, adapter_board-F_Mask.gts, adapter_board-F_Paste.gtp]
2024-04-01 directory changes
    [adapter_board-B_Cu.gbl, adapter_board-B_Mask.gbs, adapter_board-B_Paste.gbp, adapter_board-B_Silkscreen.gbo, adapter_board-Edge_Cuts.gm1, adapter_board-F_Cu.gtl, adapter_board-F_Mask.gts, adapter_board-F_Paste.gtp]
2024-04-02 extracting headset zip
    [ece445_headset-B_Cu.gbl, ece445_headset-B_Mask.gbs, ece445_headset-B_Paste.gbp, ece445_headset-B_Silkscreen.gbo, ece445_headset-Edge_Cuts.gm1, ece445_headset-F_Cu.gtl, ece445_headset-F_Mask.gts, ece445_headset-F_Paste.gtp]
2024-04-02 LED Gerbers Griffin - Post Audit
2024-04-02 LED Circuit Kicad Griffin - Post Audit
    [New.kicad_pcb, New.kicad_sch]
2024-04-08 new headset board
    [ece445_headset-B_Cu.gbl, ece445_headset-B_Mask.gbs, ece445_headset-B_Paste.gbp, ece445_headset-B_Silkscreen.gbo, ece445_headset-Edge_Cuts.gm1, ece445_headset-F_Cu.gtl, ece445_headset-F_Mask.gts, ece445_headset-F_Paste.gtp]
2024-04-09 visuals for adapter board
2024-04-10 Adding updated LED PCBs
2024-04-17 LED Circuit with pushbutton
    [Led circuit.kicad_pcb, Led circuit.kicad_sch]
2024-04-17 Circuit with switches
    [Led circuit w sw.kicad_pcb, Switch Circuit.kicad_sch]
